roberts7531/mxode_hw/fpga/mxode/impl/gwsynthesis/mxode_syn_resource.html

# Hierarchy Module Resource

MODULE NAME | REG NUMBER | ALU NUMBER | LUT NUMBER | DSP NUMBER | BSRAM NUMBER | SSRAM NUMBER
mxode_top (/home/roberts7531/ai/ps2_MXODE/fpga/mxode/src/mxode_top.sv) | - | - | 203 | - | - | -
|--mainPll (/home/roberts7531/ai/ps2_MXODE/fpga/mxode/src/mxode_top.sv) | - | - | - | - | - | -
|--sd_reader_inst (/home/roberts7531/ai/ps2_MXODE/fpga/mxode/src/mxode_top.sv) | 331 | - | 703 | - | - | -
|--sdcmd_ctrl_i (/home/roberts7531/ai/ps2_MXODE/fpga/mxode/src/sd_reader.sv) | 152 | 22 | 204 | - | - | -
|--sProcInst (/home/roberts7531/ai/ps2_MXODE/fpga/mxode/src/mxode_top.sv) | 460 | - | 357 | - | - | -
|--stm32_interface_inst (/home/roberts7531/ai/ps2_MXODE/fpga/mxode/src/sCommandProcessor.sv) | 191 | - | 255 | - | - | -
|--sckSync (/home/roberts7531/ai/ps2_MXODE/fpga/mxode/src/stm32_interface.sv) | 2 | - | - | - | - | -
|--csSync (/home/roberts7531/ai/ps2_MXODE/fpga/mxode/src/stm32_interface.sv) | 2 | - | - | - | - | -
|--mosiSync (/home/roberts7531/ai/ps2_MXODE/fpga/mxode/src/stm32_interface.sv) | 2 | - | - | - | - | -
|--writeSync (/home/roberts7531/ai/ps2_MXODE/fpga/mxode/src/sCommandProcessor.sv) | 1 | - | - | - | - | -
|--readSync (/home/roberts7531/ai/ps2_MXODE/fpga/mxode/src/sCommandProcessor.sv) | 2 | - | - | - | - | -
|--dmaCounterInst (/home/roberts7531/ai/ps2_MXODE/fpga/mxode/src/mxode_top.sv) | 13 | 12 | 2 | - | - | -
|--nProc (/home/roberts7531/ai/ps2_MXODE/fpga/mxode/src/mxode_top.sv) | 181 | - | 116 | - | - | -
|--dmaAckSync (/home/roberts7531/ai/ps2_MXODE/fpga/mxode/src/nCommandProcessor.sv) | 2 | - | - | - | - | -
|--wrSync (/home/roberts7531/ai/ps2_MXODE/fpga/mxode/src/nCommandProcessor.sv) | 1 | - | - | - | - | -
|--dmaBusySync (/home/roberts7531/ai/ps2_MXODE/fpga/mxode/src/nCommandProcessor.sv) | 2 | - | 1 | - | - | -
|--disk_buffer (/home/roberts7531/ai/ps2_MXODE/fpga/mxode/src/nCommandProcessor.sv) | 1 | - | 32 | - | 16 | -
|--dma_start_sync (/home/roberts7531/ai/ps2_MXODE/fpga/mxode/src/nCommandProcessor.sv) | 2 | - | - | - | - | -
|--dma_ack_sync (/home/roberts7531/ai/ps2_MXODE/fpga/mxode/src/nCommandProcessor.sv) | 2 | - | - | - | - | -
