roberts7531/mxode_hw/ps2_MXODE.kicad_pcb

## KiCad design ps2_MXODE.kicad_pcb (2026-10-26)

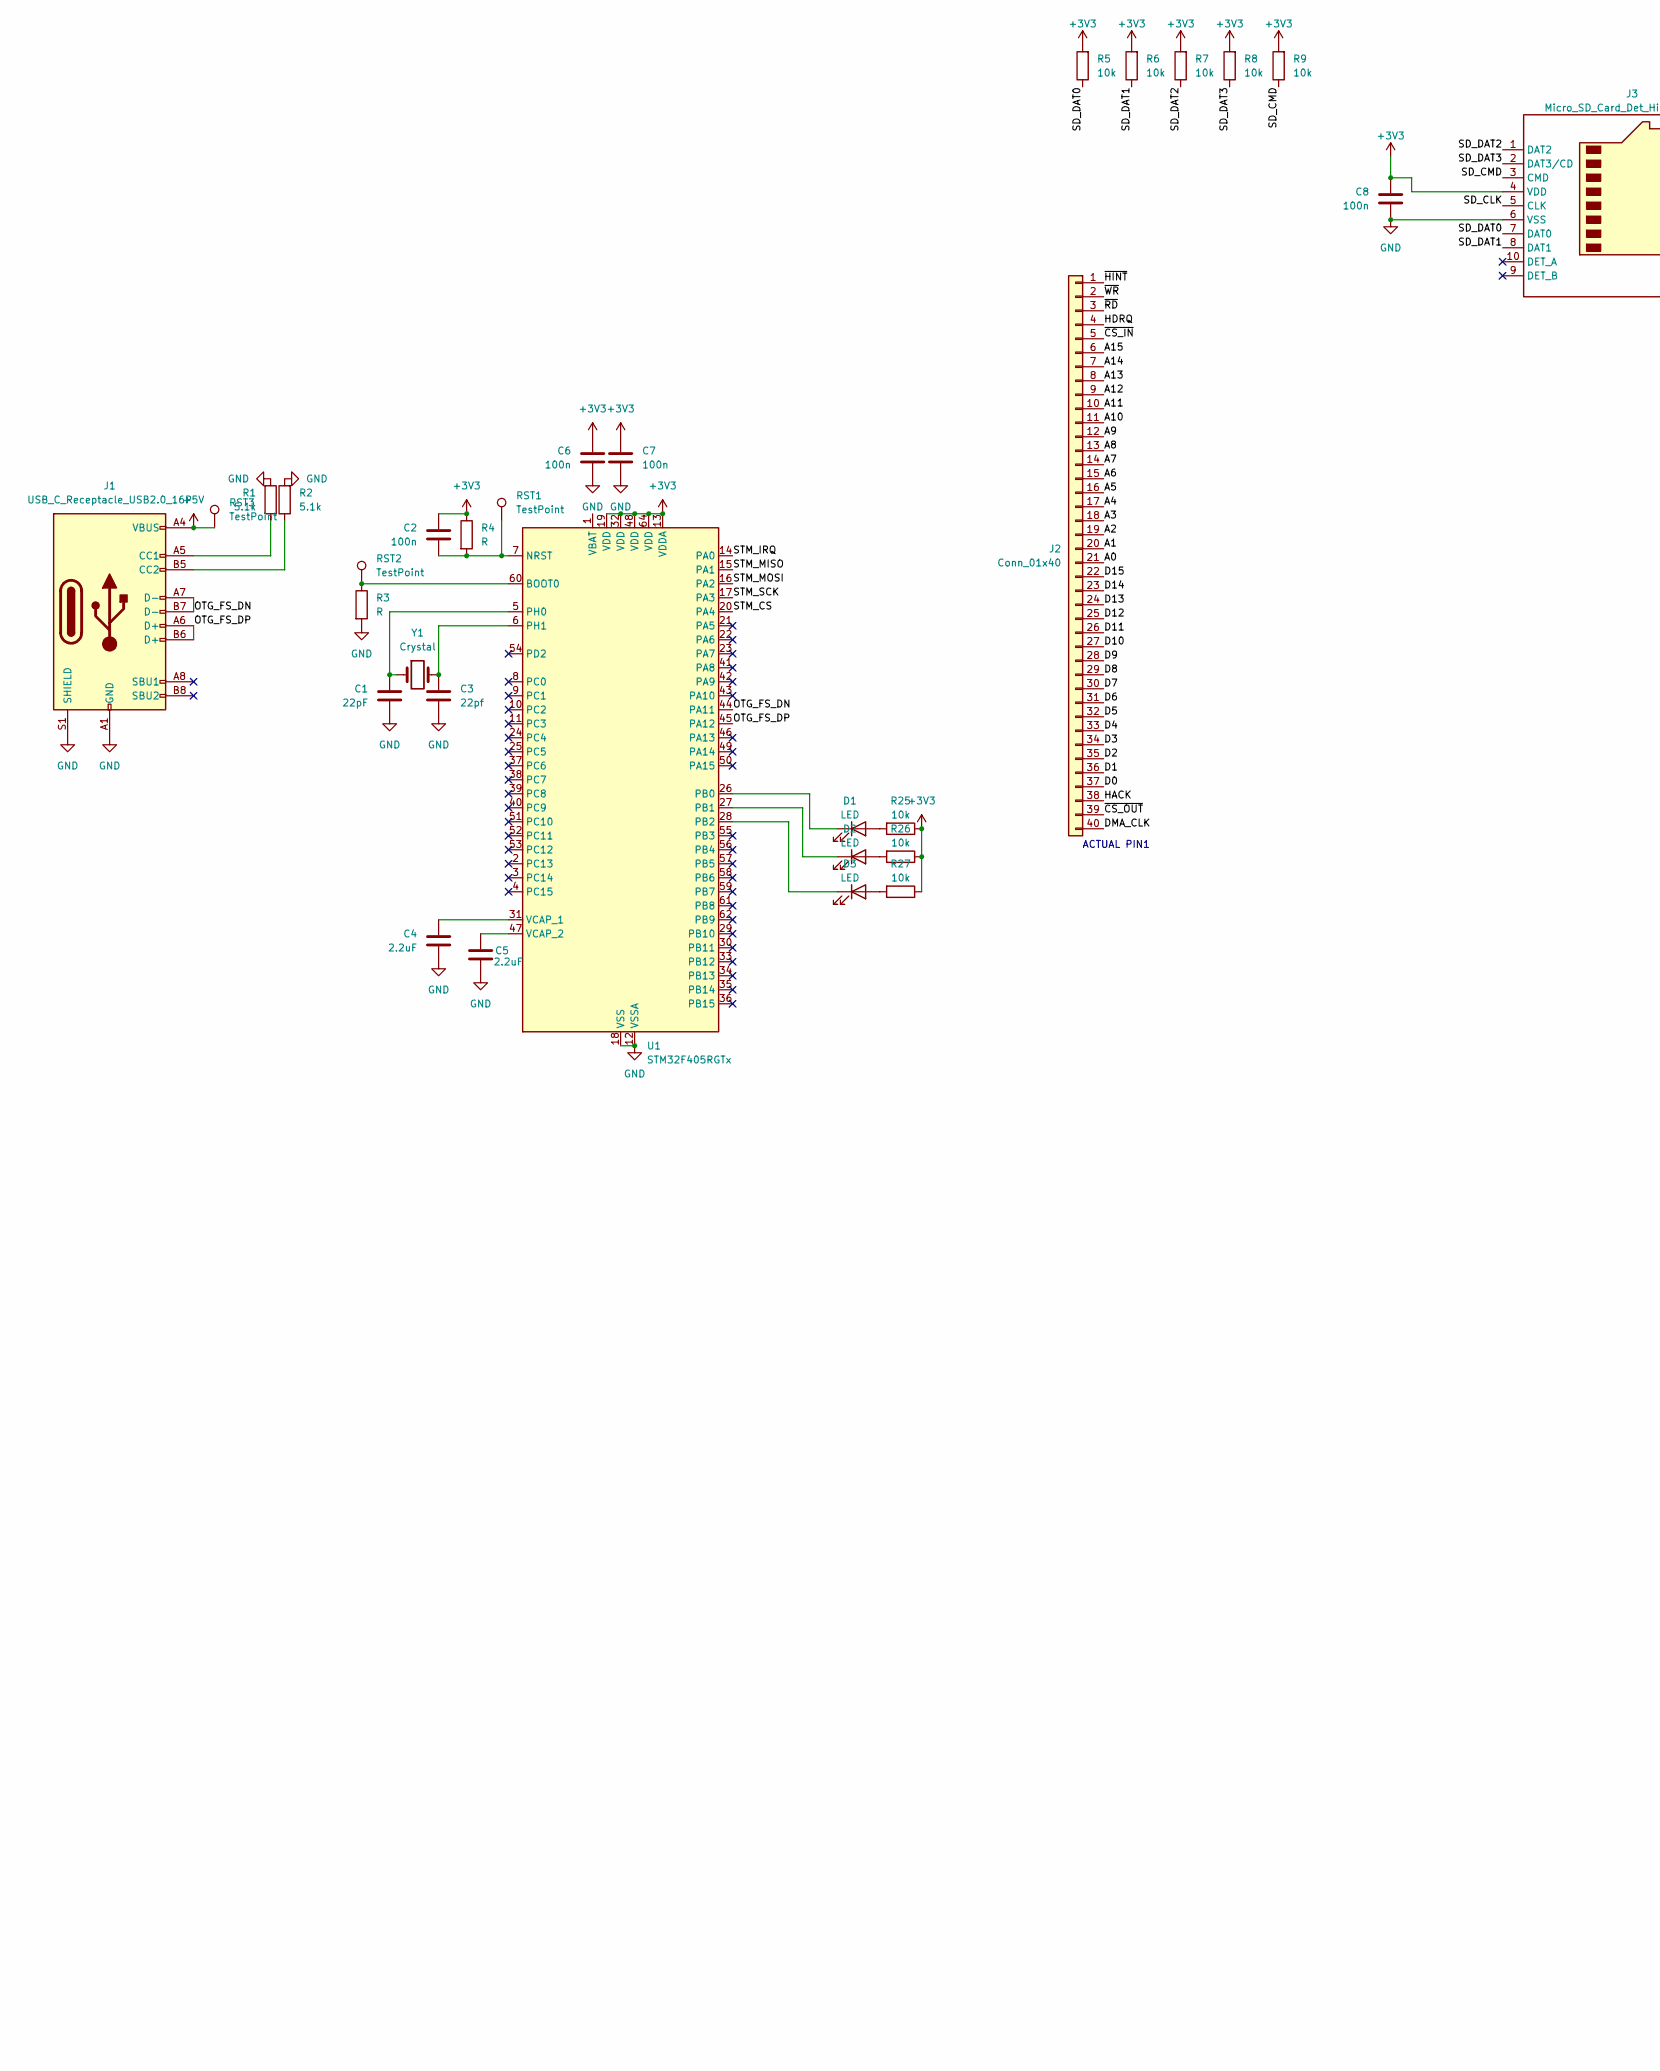
[picture p1: schematic ps2_MXODE.kicad_sch, part in row 1, column 1]

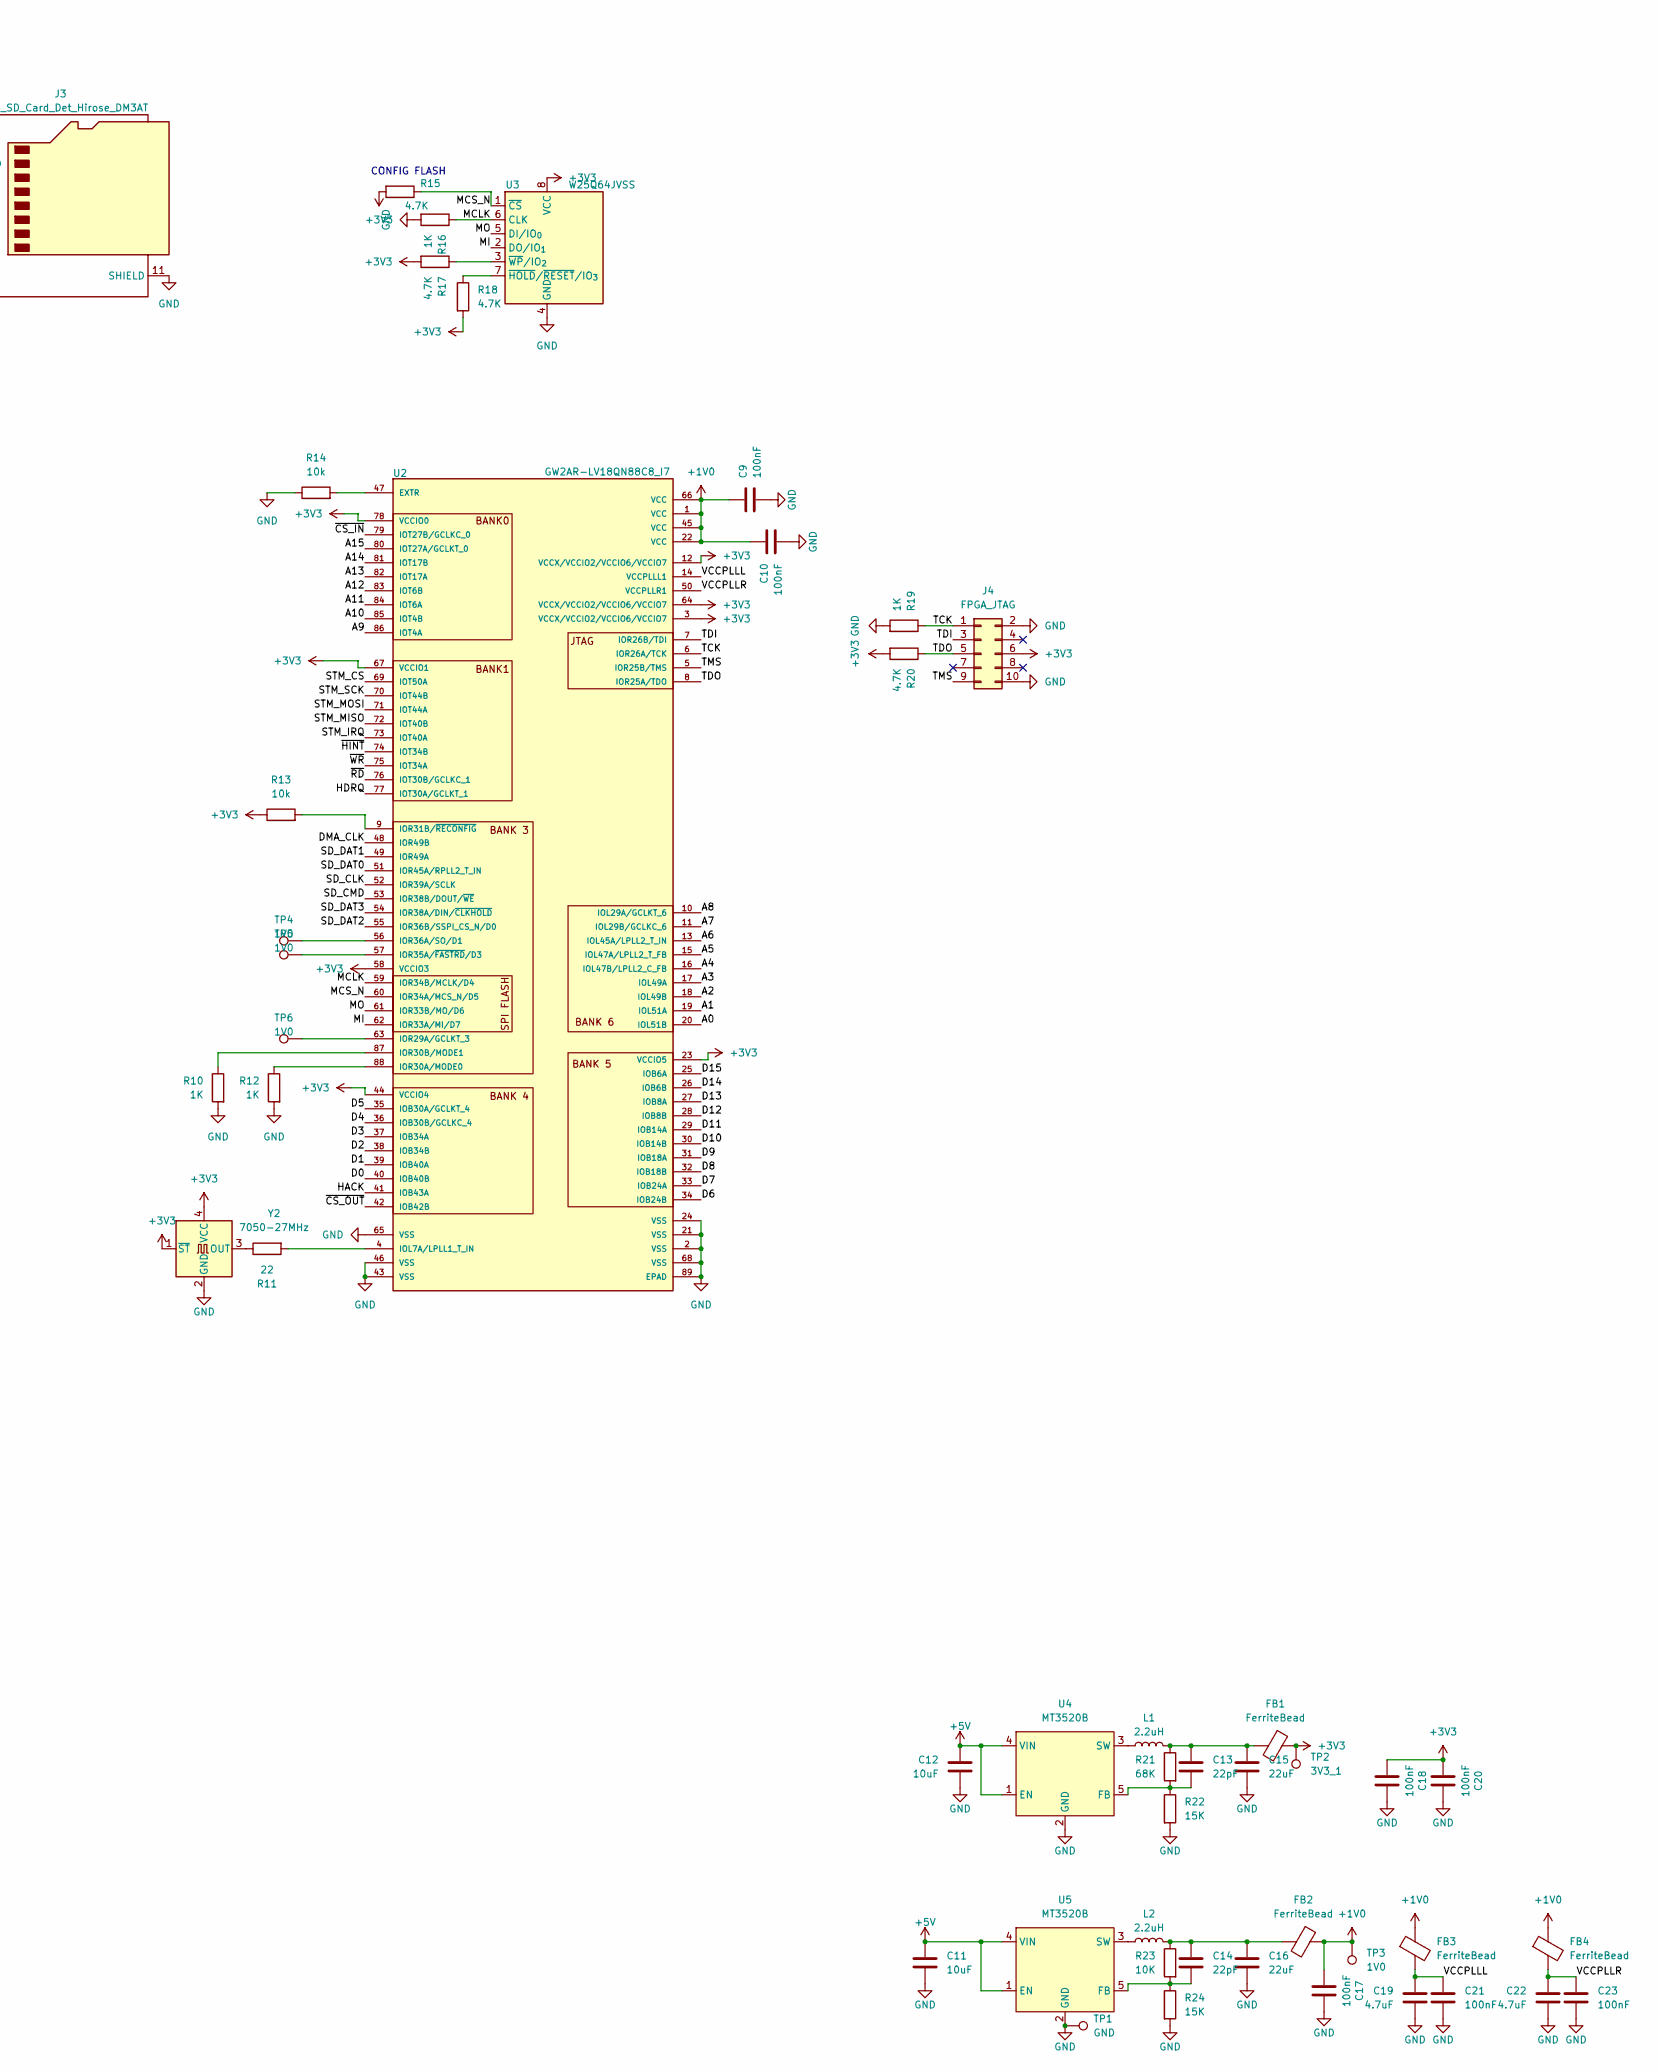
[picture p2: schematic ps2_MXODE.kicad_sch, part in row 1, column 2]

Parts:
C1, C13, C14: 22pF; C_0603_1608Metric_Pad1.08x0.95mm_HandSolder
C2, C6, C7, C8: 100n; C_0603_1608Metric_Pad1.08x0.95mm_HandSolder
C3: 22pf; C_0603_1608Metric_Pad1.08x0.95mm_HandSolder
C4, C5: 2.2uF; C_0603_1608Metric_Pad1.08x0.95mm_HandSolder
C9, C10, C17, C18, C20, C21, C23: 100nF; C_0603_1608Metric_Pad1.08x0.95mm_HandSolder
C11, C12: 10uF; C_0603_1608Metric_Pad1.08x0.95mm_HandSolder
C15, C16: 22uF; C_0603_1608Metric_Pad1.08x0.95mm_HandSolder
C19, C22: 4.7uF; C_0603_1608Metric_Pad1.08x0.95mm_HandSolder
D1, D2, D3: LED; LED_0603_1608Metric_Pad1.05x0.95mm_HandSolder
FB1, FB2, FB3, FB4: FerriteBead; L_0805_2012Metric_Pad1.05x1.20mm_HandSolder
J1: USB_C_Receptacle_USB2.0_16P; USB_C_Receptacle_GCT_USB4105-xx-A_16P_TopMnt_Horizontal
J2: Conn_01x40; Hirose_FH12-40S-0.5SH_1x40-1MP_P0.50mm_Horizontal
J3: Micro_SD_Card_Det_Hirose_DM3AT; microSD_HC_Hirose_DM3D-SF
J4: FPGA_JTAG; PinHeader_2x05_P2.54mm_Vertical
L1, L2: 2.2uH; L_1206_3216Metric_Pad1.22x1.90mm_HandSolder
R1, R2: 5.1k; R_0603_1608Metric_Pad0.98x0.95mm_HandSolder
R3, R4: R; R_0603_1608Metric_Pad0.98x0.95mm_HandSolder
R5, R6, R7, R8, R9, R13, R14, R25, R26, R27: 10k; R_0603_1608Metric_Pad0.98x0.95mm_HandSolder
R10, R12, R16, R19: 1K; R_0603_1608Metric_Pad0.98x0.95mm_HandSolder
R11: 22; R_0603_1608Metric_Pad0.98x0.95mm_HandSolder
R15, R17, R18, R20: 4.7K; R_0603_1608Metric_Pad0.98x0.95mm_HandSolder
R21: 68K; R_0603_1608Metric_Pad0.98x0.95mm_HandSolder
R22, R24: 15K; R_0603_1608Metric_Pad0.98x0.95mm_HandSolder
R23: 10K; R_0603_1608Metric_Pad0.98x0.95mm_HandSolder
RST1, RST2, RST3: TestPoint; PinSocket_1x01_P2.54mm_Vertical
TP1: GND; TestPoint_Pad_1.0x1.0mm
TP2: 3V3_1; TestPoint_Pad_1.0x1.0mm
TP3, TP4, TP5, TP6: 1V0; TestPoint_Pad_1.0x1.0mm
U1: STM32F405RGTx; LQFP-64_10x10mm_P0.5mm
U2: GW2AR-LV18QN88C8_I7; IC_GW2AR-LV18QN88C8_I7; PARTREV 2.4E
U3: W25Q64JVSS; SOIC-8_5.3x5.3mm_P1.27mm
U4, U5: MT3520B; SOT-23-5
Y1: Crystal; Crystal_HC18-U_Vertical
Y2: 7050-27MHz; Oscillator_SMD_SeikoEpson_SG8002CA-4Pin_7.0x5.0mm_HandSolde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

Connections:
+1V0: C9.1, C10.1, C17.2, FB2.1, FB3.1, FB4.1, TP3.1, U2.1 (VCC), U2.22 (VCC), U2.45 (VCC), U2.66 (VCC)
+3V3: C2.2, C6.2, C7.2, C8.2, C18.2, C20.2, FB1.1, J3.4 (VDD), J4.6, R4.1, R5.2, R6.2, R7.2, R8.2, R9.2, R13.1, R15.2, R17.2, R18.2, R20.2, R25.1, R26.1, R27.1, TP2.1, U1.13 (VDDA), U1.19 (VDD), U1.32 (VDD), U1.48 (VDD), U1.64 (VDD), U2.3 (VCCX/VCCIO2/VCCIO6/VCCIO7), U2.12 (VCCX/VCCIO2/VCCIO6/VCCIO7), U2.23 (VCCIO5), U2.44 (VCCIO4), U2.58 (VCCIO3), U2.64 (VCCX/VCCIO2/VCCIO6/VCCIO7), U2.67 (VCCIO1), U2.78 (VCCIO0), U3.8 (VCC), Y2.1 (~ST), Y2.4 (VCC)
+5V: C11.1, C12.1, J1.A4 (VBUS), J1.A9 (VBUS), J1.B4 (VBUS), J1.B9 (VBUS), RST3.1, U4.1 (EN), U4.4 (VIN), U5.1 (EN), U5.4 (VIN)
/A0: J2.21, U2.20 (IOL51B)
/A1: J2.20, U2.19 (IOL51A)
/A2: J2.19, U2.18 (IOL49B)
/A3: J2.18, U2.17 (IOL49A)
/A4: J2.17, U2.16 (IOL47B/LPLL2_C_FB)
/A5: J2.16, U2.15 (IOL47A/LPLL2_T_FB)
/A6: J2.15, U2.13 (IOL45A/LPLL2_T_IN)
/A7: J2.14, U2.11 (IOL29B/GCLKC_6)
/A8: J2.13, U2.10 (IOL29A/GCLKT_6)
/A9: J2.12, U2.86 (IOT4A)
/A10: J2.11, U2.85 (IOT4B)
/A11: J2.10, U2.84 (IOT6A)
/A12: J2.9, U2.83 (IOT6B)
/A13: J2.8, U2.82 (IOT17A)
/A14: J2.7, U2.81 (IOT17B)
/A15: J2.6, U2.80 (IOT27A/GCLKT_0)
/D0: J2.37, U2.40 (IOB40B)
/D1: J2.36, U2.39 (IOB40A)
/D2: J2.35, U2.38 (IOB34B)
/D3: J2.34, U2.37 (IOB34A)
/D4: J2.33, U2.36 (IOB30B/GCLKC_4)
/D5: J2.32, U2.35 (IOB30A/GCLKT_4)
/D6: J2.31, U2.34 (IOB24B)
/D7: J2.30, U2.33 (IOB24A)
/D8: J2.29, U2.32 (IOB18B)
/D9: J2.28, U2.31 (IOB18A)
/D10: J2.27, U2.30 (IOB14B)
/D11: J2.26, U2.29 (IOB14A)
/D12: J2.25, U2.28 (IOB8B)
/D13: J2.24, U2.27 (IOB8A)
/D14: J2.23, U2.26 (IOB6B)
/D15: J2.22, U2.25 (IOB6A)
/DMA_CLK: J2.40, U2.48 (IOR49B)
/HACK: J2.39, U2.42 (IOB42B)
/HDRQ: J2.4, U2.77 (IOT30A/GCLKT_1)
/MCLK: R16.1, U2.59 (IOR34B/MCLK/D4), U3.6 (CLK)
/MCS_N: R15.1, U2.60 (IOR34A/MCS_N/D5), U3.1 (~CS)
/MI: U2.62 (IOR33A/MI/D7), U3.2 (DO/IO_{1})
/MO: U2.61 (IOR33B/MO/D6), U3.5 (DI/IO_{0})
/OTG_FS_DN: J1.A7 (D-), J1.B7 (D-), U1.44 (PA11)
/OTG_FS_DP: J1.A6 (D+), J1.B6 (D+), U1.45 (PA12)
/SD_CLK: J3.5 (CLK), U2.52 (IOR39A/SCLK)
/SD_CMD: J3.3 (CMD), R9.1, U2.53 (IOR38B/DOUT/~WE)
/SD_DAT0: J3.7 (DAT0), R5.1, U2.51 (IOR45A/RPLL2_T_IN)
/SD_DAT1: J3.8 (DAT1), R6.1, U2.49 (IOR49A)
/SD_DAT2: J3.1 (DAT2), R7.1, U2.55 (IOR36B/SSPI_CS_N/D0)
/SD_DAT3: J3.2 (DAT3/CD), R8.1, U2.54 (IOR38A/DIN/~CLKHOLD)
/STM_CS: U1.20 (PA4), U2.69 (IOT50A)
/STM_IRQ: U1.14 (PA0), U2.73 (IOT40A)
/STM_MISO: U1.15 (PA1), U2.72 (IOT40B)
/STM_MOSI: U1.16 (PA2), U2.71 (IOT44A)
/STM_SCK: U1.17 (PA3), U2.70 (IOT44B)
/TCK: J4.1, R19.1, U2.6 (IOR26A/TCK)
/TDI: J4.3, U2.7 (IOR26B/TDI)
/TDO: J4.5, R20.1, U2.8 (IOR25A/TDO)
/TMS: J4.9, U2.5 (IOR25B/TMS)
/VCCPLLL: C19.1, C21.1, FB3.2, U2.14 (VCCPLLL1)
/VCCPLLR: C22.1, C23.1, FB4.2, U2.50 (VCCPLLR1)
/~CS_IN: J2.5, U2.79 (IOT27B/GCLKC_0)
/~CS_OUT: J2.38, U2.41 (IOB43A)
/~HINT: J2.1, U2.74 (IOT34B)
/~RD: J2.3, U2.76 (IOT30B/GCLKC_1)
/~WR: J2.2, U2.75 (IOT34A)
GND: C1.1, C3.1, C4.1, C5.2, C6.1, C7.1, C8.1, C9.2, C10.2, C11.2, C12.2, C15.2, C16.2, C17.1, C18.1, C19.2, C20.1, C21.2, C22.2, C23.2, J1.A1 (GND), J1.A12 (GND), J1.B1 (GND), J1.B12 (GND), J1.S1 (SHIELD), J3.6 (VSS), J3.11 (SHIELD), J4.2, J4.10, R1.2, R2.2, R3.2, R10.2, R12.2, R14.1, R16.2, R19.2, R22.2, R24.2, TP1.1, U1.12 (VSSA), U1.18 (VSS), U1.63 (VSS), U2.2 (VSS), U2.21 (VSS), U2.24 (VSS), U2.43 (VSS), U2.46 (VSS), U2.65 (VSS), U2.68 (VSS), U2.89 (EPAD), U3.4 (GND), U4.2 (GND), U5.2 (GND), Y2.2 (GND)
unnamed: C13.1, C15.1, FB1.2, L1.2, R21.1
unnamed: C14.1, C16.1, FB2.2, L2.2, R23.1
unnamed: D1.2 (A), R25.2
unnamed: D1.1 (K), U1.26 (PB0)
unnamed: D2.2 (A), R26.2
unnamed: D2.1 (K), U1.27 (PB1)
unnamed: D3.2 (A), R27.2
unnamed: D3.1 (K), U1.28 (PB2)
unnamed: J1.A5 (CC1), R1.1
unnamed: J1.B5 (CC2), R2.1
unnamed: R3.1, RST2.1, U1.60 (BOOT0)
unnamed: C2.1, R4.2, RST1.1, U1.7 (NRST)
unnamed: C1.2, U1.5 (PH0), Y1.1
unnamed: C3.2, U1.6 (PH1), Y1.2
unnamed: C4.2, U1.31 (VCAP_1)
unnamed: C5.1, U1.47 (VCAP_2)
unnamed: R14.2, U2.47 (EXTR)
unnamed: R11.2, U2.4 (IOL7A/LPLL1_T_IN)
unnamed: TP6.1, U2.63 (IOR29A/GCLKT_3)
unnamed: R12.1, U2.88 (IOR30A/MODE0)
unnamed: R10.1, U2.87 (IOR30B/MODE1)
unnamed: R13.2, U2.9 (IOR31B/~RECONFIG)
unnamed: TP5.1, U2.57 (IOR35A/~FASTRD/D3)
unnamed: TP4.1, U2.56 (IOR36A/SO/D1)
unnamed: R18.1, U3.7 (~HOLD/~RESET/IO_{3})
unnamed: R17.1, U3.3 (~WP/IO_{2})
unnamed: C13.2, R21.2, R22.1, U4.5 (FB)
unnamed: L1.1, U4.3 (SW)
unnamed: C14.2, R23.2, R24.1, U5.5 (FB)
unnamed: L2.1, U5.3 (SW)
unnamed: R11.1, Y2.3 (OUT)

Notes on the sheet:
CONFIG FLASH
ACTUAL PIN1

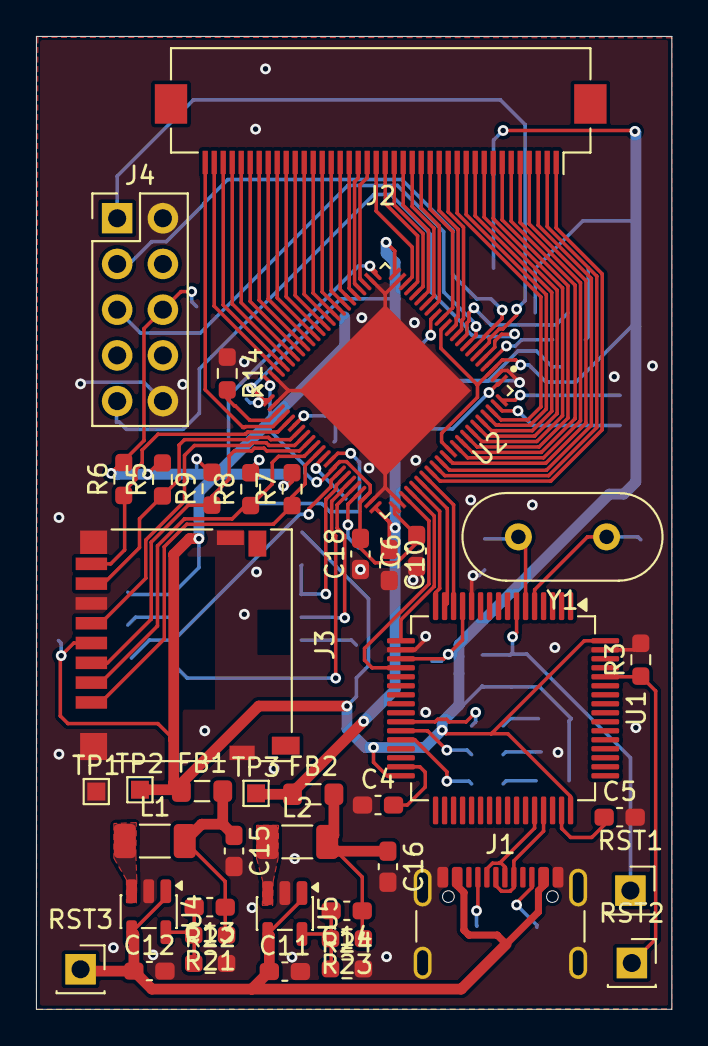
[picture p3: board ps2_MXODE.kicad_pcb from above]

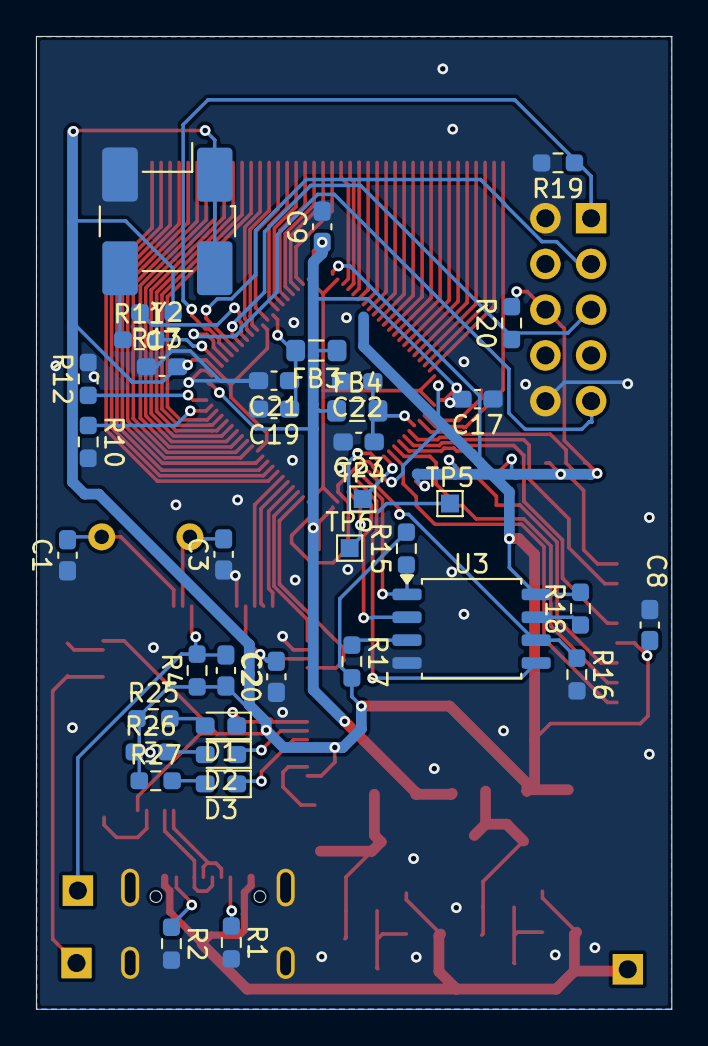
[picture p4: board ps2_MXODE.kicad_pcb from below]

Board: 2 copper layers, 35.3 x 54.0 mm, 79 parts (38 on the bottom side), 98 nets.
