roberts7531/mxode_hw/fpga/mxode/impl/gwsynthesis/RTL_GAO/gw_gao_top.v

module gw_gao(
    \nProc/dmaByteCount[31] ,
    \nProc/dmaByteCount[30] ,
    \nProc/dmaByteCount[29] ,
    \nProc/dmaByteCount[28] ,
    \nProc/dmaByteCount[27] ,
    \nProc/dmaByteCount[26] ,
    \nProc/dmaByteCount[25] ,
    \nProc/dmaByteCount[24] ,
    \nProc/dmaByteCount[23] ,
    \nProc/dmaByteCount[22] ,
    \nProc/dmaByteCount[21] ,
    \nProc/dmaByteCount[20] ,
    \nProc/dmaByteCount[19] ,
    \nProc/dmaByteCount[18] ,
    \nProc/dmaByteCount[17] ,
    \nProc/dmaByteCount[16] ,
    \nProc/dmaByteCount[15] ,
    \nProc/dmaByteCount[14] ,
    \nProc/dmaByteCount[13] ,
    \nProc/dmaByteCount[12] ,
    \nProc/dmaByteCount[11] ,
    \nProc/dmaByteCount[10] ,
    \nProc/dmaByteCount[9] ,
    \nProc/dmaByteCount[8] ,
    \nProc/dmaByteCount[7] ,
    \nProc/dmaByteCount[6] ,
    \nProc/dmaByteCount[5] ,
    \nProc/dmaByteCount[4] ,
    \nProc/dmaByteCount[3] ,
    \nProc/dmaByteCount[2] ,
    \nProc/dmaByteCount[1] ,
    \nProc/dmaByteCount[0] ,
    HACK,
    \nProc/ack_sampled ,
    dsp_cs_in,
    dsp_rd,
    dsp_wr,
    \nProc/cs_sync ,
    dma_clk,
    \dmaDataOut[31] ,
    \dmaDataOut[30] ,
    \dmaDataOut[29] ,
    \dmaDataOut[28] ,
    \dmaDataOut[27] ,
    \dmaDataOut[26] ,
    \dmaDataOut[25] ,
    \dmaDataOut[24] ,
    \dmaDataOut[23] ,
    \dmaDataOut[22] ,
    \dmaDataOut[21] ,
    \dmaDataOut[20] ,
    \dmaDataOut[19] ,
    \dmaDataOut[18] ,
    \dmaDataOut[17] ,
    \dmaDataOut[16] ,
    \dmaDataOut[15] ,
    \dmaDataOut[14] ,
    \dmaDataOut[13] ,
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
wire \dmaByteCount[1] ;
wire \dmaByteCount[0] ;
wire tms_pad_i;
wire tck_pad_i;
wire tdi_pad_i;
wire tdo_pad_o;
wire tms_i_c;
wire tck_i_c;
wire tdi_i_c;
wire tdo_o_c;
wire [9:0] control0;
wire gao_jtag_tck;
wire gao_jtag_reset;
wire run_test_idle_er1;
wire run_test_idle_er2;
wire shift_dr_capture_dr;
wire update_dr;
wire pause_dr;
wire enable_er1;
wire enable_er2;
wire gao_jtag_tdi;
wire tdo_er1;

IBUF tms_ibuf (
    .I(tms_pad_i),
    .O(tms_i_c)
);

IBUF tck_ibuf (
    .I(tck_pad_i),
    .O(tck_i_c)
);

IBUF tdi_ibuf (
    .I(tdi_pad_i),
    .O(tdi_i_c)
);

OBUF tdo_obuf (
    .I(tdo_o_c),
    .O(tdo_pad_o)
);

GW_JTAG  u_gw_jtag(
    .tms_pad_i(tms_i_c),
    .tck_pad_i(tck_i_c),
    .tdi_pad_i(tdi_i_c),
    .tdo_pad_o(tdo_o_c),
    .tck_o(gao_jtag_tck),
    .test_logic_reset_o(gao_jtag_reset),
    .run_test_idle_er1_o(run_test_idle_er1),
    .run_test_idle_er2_o(run_test_idle_er2),
    .shift_dr_capture_dr_o(shift_dr_capture_dr),
    .update_dr_o(update_dr),
    .pause_dr_o(pause_dr),
    .enable_er1_o(enable_er1),
    .enable_er2_o(enable_er2),
    .tdi_o(gao_jtag_tdi),
    .tdo_er1_i(tdo_er1),
    .tdo_er2_i(1'b0)
);

gw_con_top  u_icon_top(
    .tck_i(gao_jtag_tck),
    .tdi_i(gao_jtag_tdi),
    .tdo_o(tdo_er1),
    .rst_i(gao_jtag_reset),
    .control0(control0[9:0]),
    .enable_i(enable_er1),
    .shift_dr_capture_dr_i(shift_dr_capture_dr),
    .update_dr_i(update_dr)
);

ao_top_0  u_la0_top(
    .control(control0[9:0]),
    .trig0_i({\dmaByteCount[31] ,\dmaByteCount[30] ,\dmaByteCount[29] ,\dmaByteCount[28] ,\dmaByteCount[27] ,\dmaByteCount[26] ,\dmaByteCount[25] ,\dmaByteCount[24] ,\dmaByteCount[23] ,\dmaByteCount[22] ,\dmaByteCount[21] ,\dmaByteCount[20] ,\dmaByteCount[19] ,\dmaByteCount[18] ,\dmaByteCount[17] ,\dmaByteCount[16] ,\dmaByteCount[15] ,\dmaByteCount[14] ,\dmaByteCount[13] ,\dmaByteCount[12] ,\dmaByteCount[11] ,\dmaByteCount[10] ,\dmaByteCount[9] ,\dmaByteCount[8] ,\dmaByteCount[7] ,\dmaByteCount[6] ,\dmaByteCount[5] ,\dmaByteCount[4] ,\dmaByteCount[3] ,\dmaByteCount[2] ,\dmaByteCount[1] ,\dmaByteCount[0] }),
    .data_i({\nProc/dmaByteCount[31] ,\nProc/dmaByteCount[30] ,\nProc/dmaByteCount[29] ,\nProc/dmaByteCount[28] ,\nProc/dmaByteCount[27] ,\nProc/dmaByteCount[26] ,\nProc/dmaByteCount[25] ,\nProc/dmaByteCount[24] ,\nProc/dmaByteCount[23] ,\nProc/dmaByteCount[22] ,\nProc/dmaByteCount[21] ,\nProc/dmaByteCount[20] ,\nProc/dmaByteCount[19] ,\nProc/dmaByteCount[18] ,\nProc/dmaByteCount[17] ,\nProc/dmaByteCount[16] ,\nProc/dmaByteCount[15] ,\nProc/dmaByteCount[14] ,\nProc/dmaByteCount[13] ,\nProc/dmaByteCount[12] ,\nProc/dmaByteCount[11] ,\nProc/dmaByteCount[10] ,\nProc/dmaByteCount[9] ,\nProc/dmaByteCount[8] ,\nProc/dmaByteCount[7] ,\nProc/dmaByteCount[6] ,\nProc/dmaByteCount[5] ,\nProc/dmaByteCount[4] ,\nProc/dmaByteCount[3] ,\nProc/dmaByteCount[2] ,\nProc/dmaByteCount[1] ,\nProc/dmaByteCount[0] ,HACK,\nProc/ack_sampled ,dsp_cs_in,dsp_rd,dsp_wr,\nProc/cs_sync ,dma_clk,\dmaDataOut[31] ,\dmaDataOut[30] ,\dmaDataOut[29] ,\dmaDataOut[28] ,\dmaDataOut[27] ,\dmaDataOut[26] ,\dmaDataOut[25] ,\dmaDataOut[24] ,\dmaDataOut[23] ,\dmaDataOut[22] ,\dmaDataOut[21] ,\dmaDataOut[20] ,\dmaDataOut[19] ,\dmaDataOut[18] ,\dmaDataOut[17] ,\dmaDataOut[16] ,\dmaDataOut[15] ,\dmaDataOut[14] ,\dmaDataOut[13] ,\dmaDataOut[12] ,\dmaDataOut[11] ,\dmaDataOut[10] ,\dmaDataOut[9] ,\dmaDataOut[8] ,\dmaDataOut[7] ,\dmaDataOut[6] ,\dmaDataOut[5] ,\dmaDataOut[4] ,\dmaDataOut[3] ,\dmaDataOut[2] ,\dmaDataOut[1] ,\dmaDataOut[0] ,HDRQ,\nProc/currentDmaState[3] ,\nProc/currentDmaState[2] ,\nProc/currentDmaState[1] ,\nProc/currentDmaState[0] }),
    .clk_i(dma_clk)
);

endmodule
