roberts7531/mxode_hw/fpga/mxode/src/fifo_hs/fifo_hs_tmp.v

//Copyright (C)2014-2025 Gowin Semiconductor Corporation.
//All rights reserved.
//File Title: Template file for instantiation
//Tool Version: V1.9.12 (64-bit)
//Part Number: GW2AR-LV18QN88C8/I7
//Device: GW2AR-18
//Created Time: Sun Oct 25 00:11:54 2026

//Change the instance name and port connections to the signal names
//--------Copy here to design--------

	FIFO_HS_Top your_instance_name(
		.Data(Data), //input [7:0] Data
		.WrClk(WrClk), //input WrClk
		.RdClk(RdClk), //input RdClk
		.WrEn(WrEn), //input WrEn
		.RdEn(RdEn), //input RdEn
		.Rnum(Rnum), //output [13:0] Rnum
		.Q(Q), //output [31:0] Q
		.Empty(Empty), //output Empty
		.Full(Full) //output Full
	);

//--------Copy end-------------------
