roberts7531/mxode_hw/(commit log)

2026-10-24 Currently working, possibly random freezes, cmd17 chain slow, about to move cmd18...
2026-10-26 Corrected schematic
2026-10-26 Checkpoint: working build with all S-commands forwarded to STM32
2026-10-27 MXODE: 45 MHz high-speed mode, read retry, clean debug-free build
    SD interface:
    - Add CMD6 (SWITCH_FUNC) negotiation and run at 45 MHz when the card
    accepts high-speed mode; stay at 22.5 MHz default speed otherwise.
    - Sample data and start tokens on the SD clock rising edge
    (sdclk_sample from sdcmd_ctrl) instead of the delayed edge detect,
    which landed on the falling edge at 45 MHz.
    - Fix the clock divider so clkdiv = 0xFFFF yields the 2-core-clock
    45 MHz period.
    Read robustness:
    - Retry a chunk silently when the card fails to send a data start token
    (token timeout), up to 2 extra attempts. The first retry also drops
    back to the proven 22.5 MHz clock, which is always legal.
    - B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
